GadgetReboot/Varta_To_CR2032/README.md

# Varta_To_CR2032
Use a CR2032 3V coin cell as a replacement for 3.6V Varta NiCd batteries on old motherboards.
<BR>Inspired by https://github.com/wiretap-retro/Not-A-Varta 
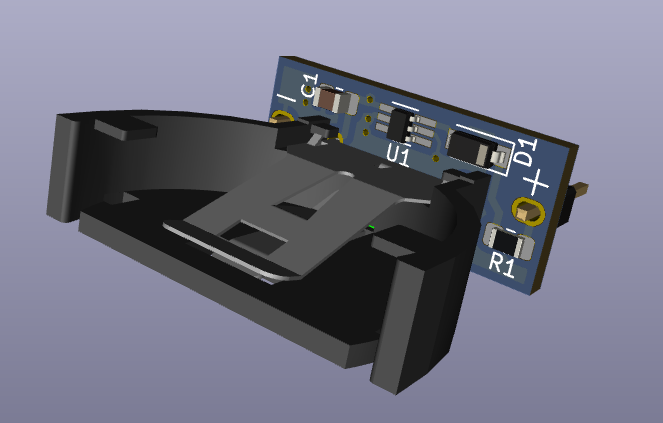
[picture p1: 3D_PCB.png]
PCB
<br><br><br><br>
