GadgetReboot/Varta_To_CR2032/KiCad/3D_Models/s8401-46_asm.stp

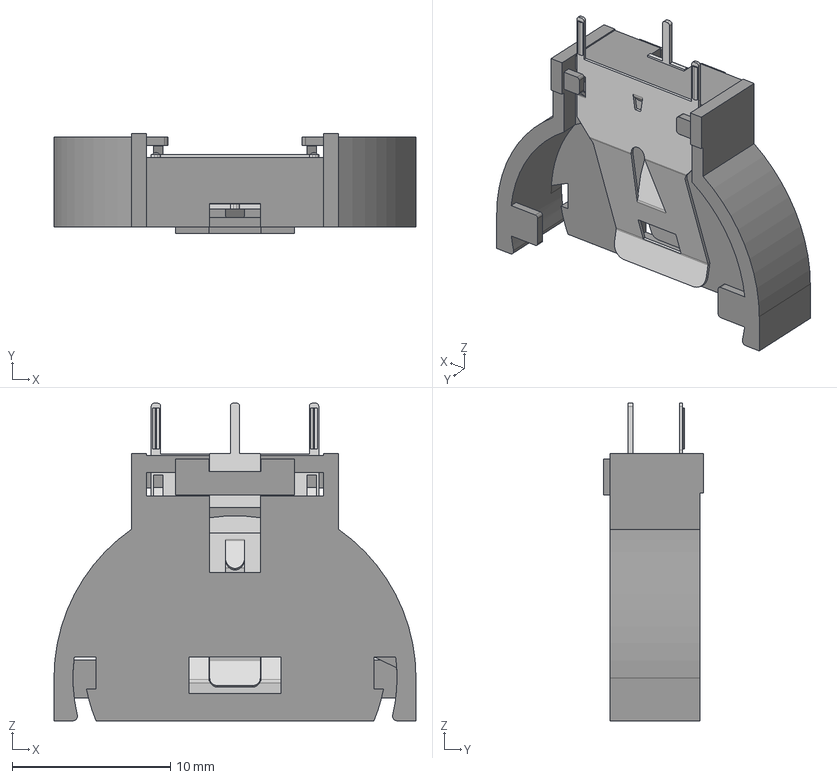
[picture p2: CAD file, 2023-03-13]
KiCad/3D_Models/s8401-46_asm.stp
22.9 x 6.30 x 20.1 mm
S840_HOLDER
S840_HOLDER_INSERT
S840_LOWER_CONTACT
S840_CONTACT
