GadgetReboot/Varta_To_CR2032/Sch_GR_Varta_To_CR2032.pdf

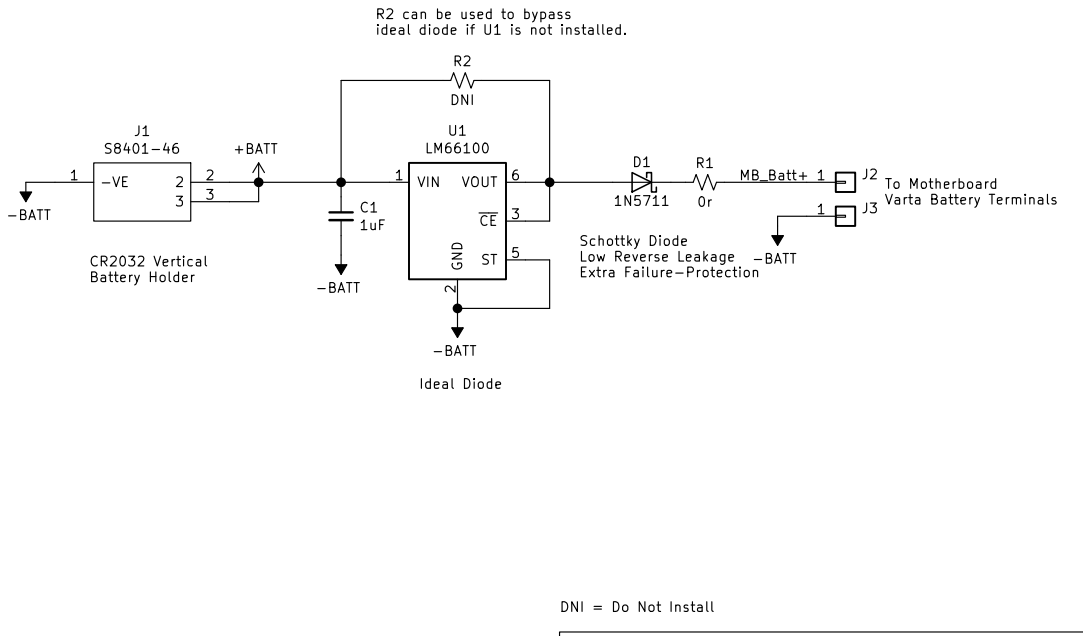
[picture p3: page 1]

ideal diode if U1 is not installed.

https://github.com/GadgetReboot/Varta_To_CR2032
File: GR_Varta_To_CR2032.sch Sheet: / Gadget Reboot

Id: 1/1 Title: Varta To CR2032
