GadgetReboot/Varta_To_CR2032/KiCad/GR_Varta_To_CR2032.kicad_pcb

## KiCad design KiCad/GR_Varta_To_CR2032.kicad_pcb (2024-04-23)

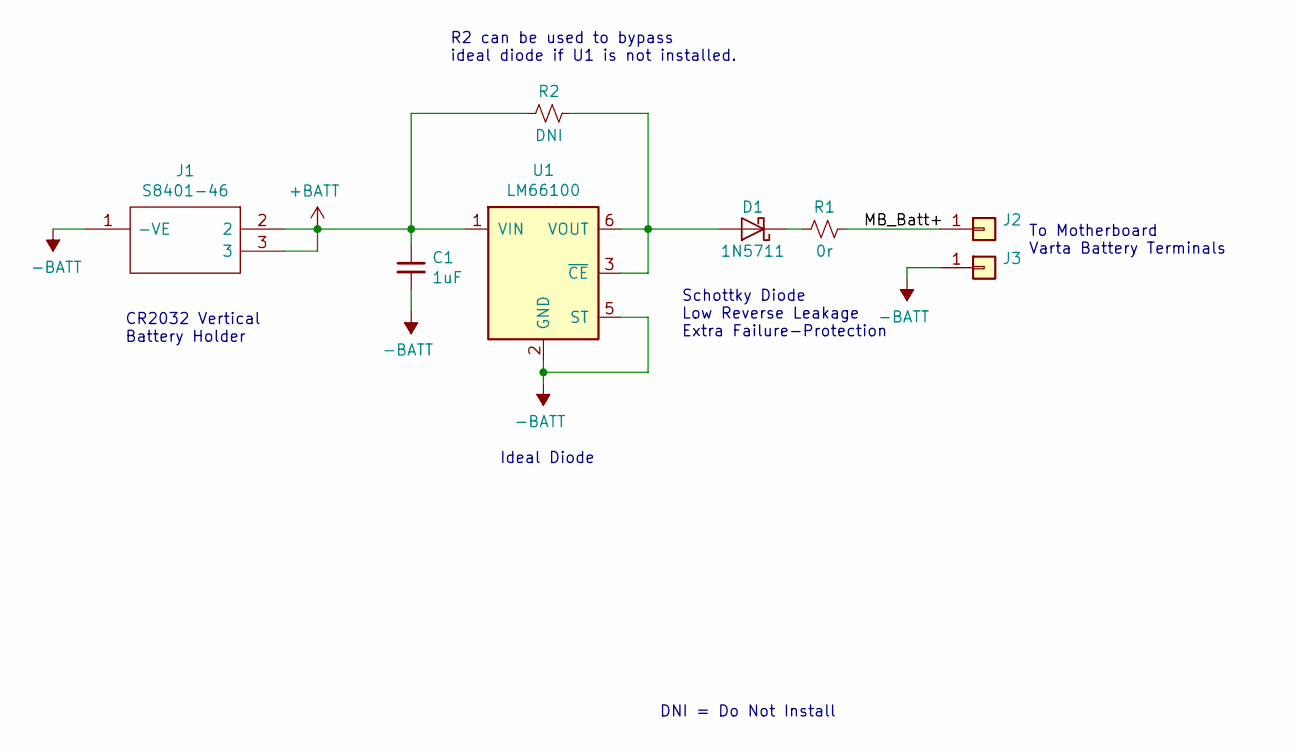
[picture p4: schematic GR_Varta_To_CR2032.sch, Varta To CR2032]

Parts:
C1: 1uF; C_0805_2012Metric_Pad1.15x1.40mm_HandSolder
D1: 1N5711; D_SOD-123
J1: S8401-46; Manufacturer_Part_Number S8401-46
J2, J3: Conn_01x01; PinHeader_1x01_P2.54mm_Vertical
R1: 0r; R_0805_2012Metric_Pad1.15x1.40mm_HandSolder
R2: DNI; R_0805_2012Metric_Pad1.15x1.40mm_HandSolder
U1: LM66100; SOT-363_SC-70-6_Handsoldering

Connections:
+BATT: C1.1, J1.2, J1.3, R2.2, U1.1 (VIN)
-BATT: C1.2, J1.1 (-VE), J3.1, U1.2 (GND), U1.5 (ST)
/MB_Batt+: J2.1, R1.1
unnamed: D1.1 (K), R1.2
unnamed: D1.2 (A), R2.1, U1.3 (~CE), U1.6 (VOUT)

Notes on the sheet:
Schottky Diode Low Reverse Leakage Extra Failure-Protection
CR2032 Vertical Battery Holder
To Motherboard Varta Battery Terminals
Ideal Diode
DNI = Do Not Install
R2 can be used to bypass ideal diode if U1 is not installed.

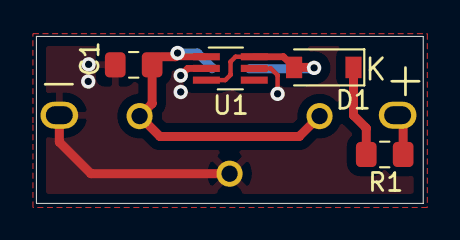
[picture p5: board GR_Varta_To_CR2032.kicad_pcb from above]

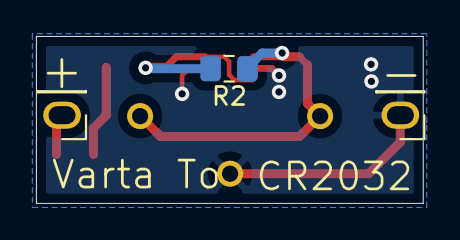
[picture p6: board GR_Varta_To_CR2032.kicad_pcb from below]

Board: 2 copper layers, 21.5 x 9.3 mm, 8 parts (3 on the bottom side), 5 nets.
